TheWasian/Group5-ENGG3000/ESP-32 Code/Digram.png

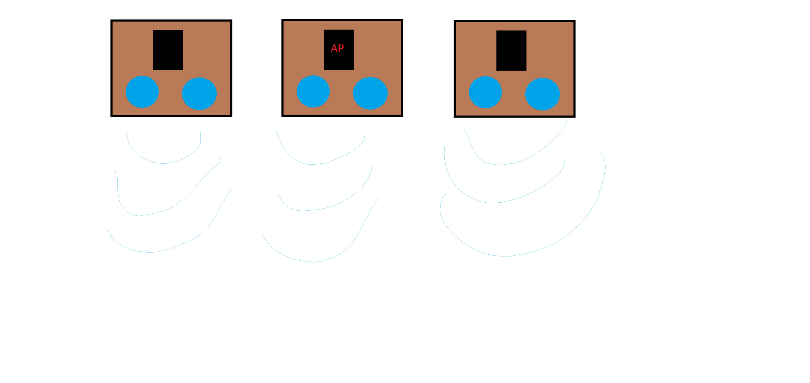
ESP-32 Code/Digram.png
