TheWasian/Group5-ENGG3000/WeeklyLogs/Images/Dash.png.png

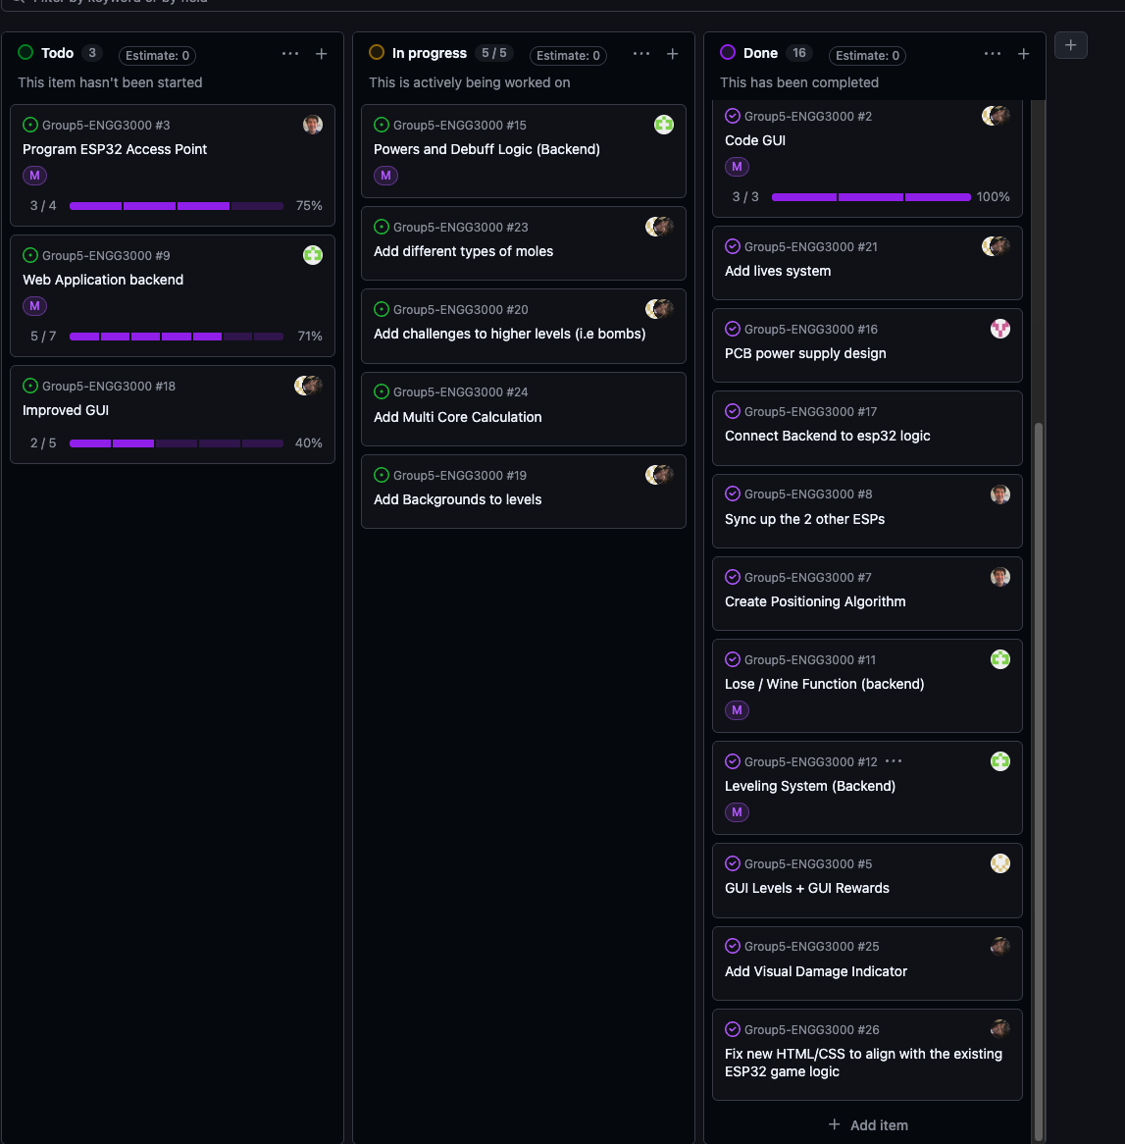
WeeklyLogs/Images/Dash.png.png
