TheWasian/Group5-ENGG3000/WeeklyLogs/Images/Dashboard 2.png

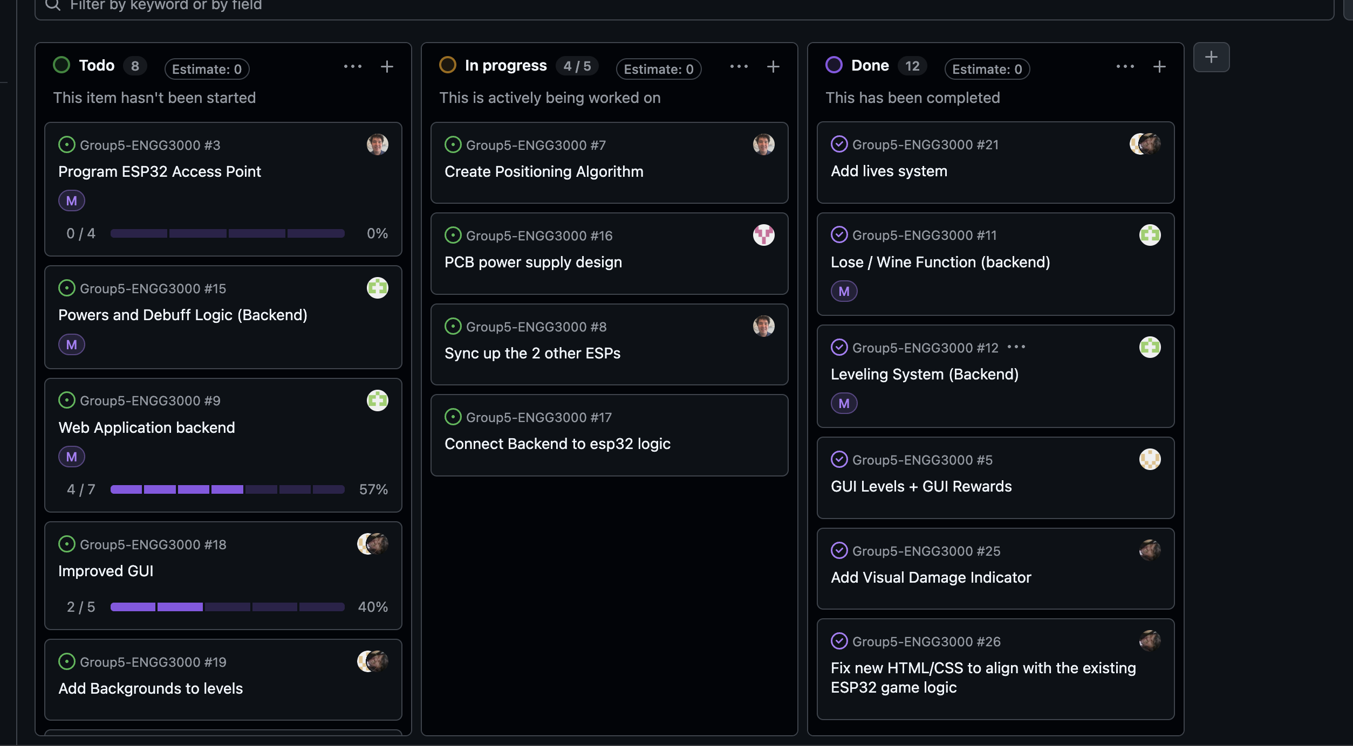
WeeklyLogs/Images/Dashboard 2.png
