TheWasian/Group5-ENGG3000/WeeklyLogs/Images/Dashboard.png

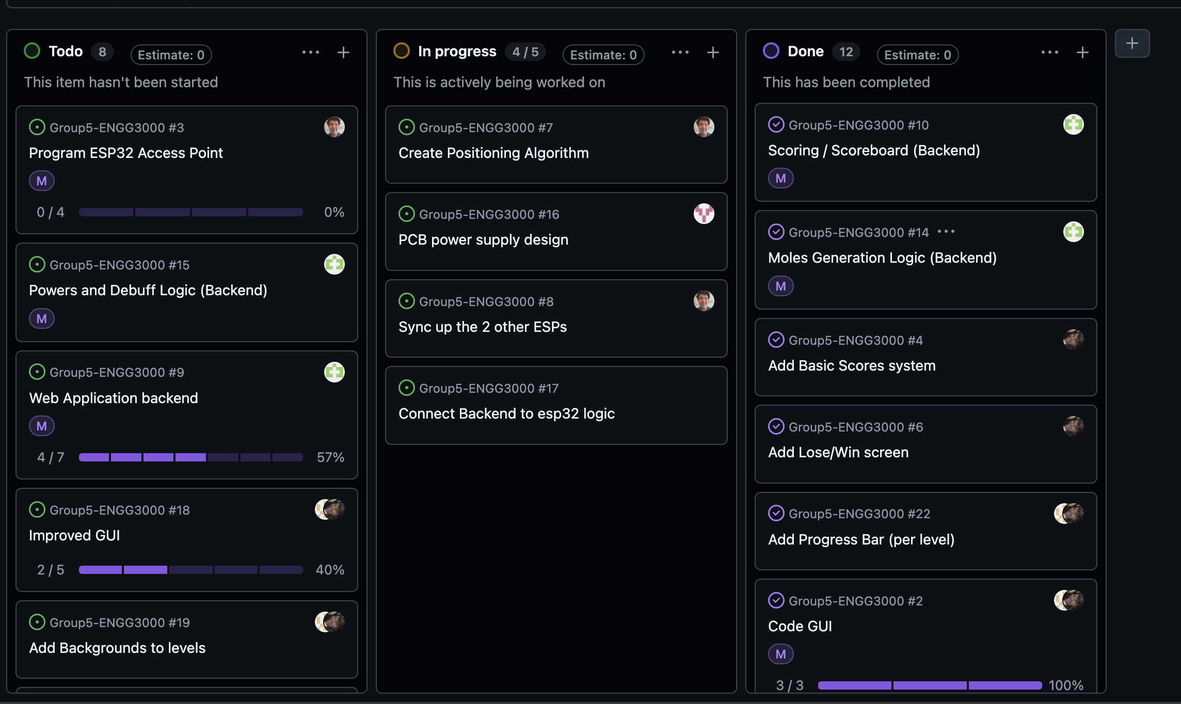
WeeklyLogs/Images/Dashboard.png
