TheWasian/Group5-ENGG3000/WeeklyLogs/Images/ImprovedUI.png.png

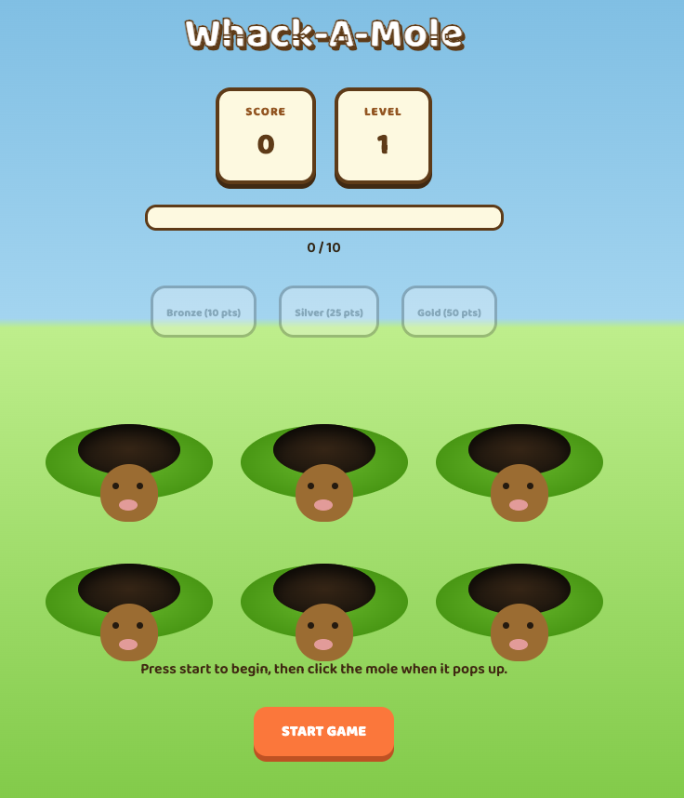
WeeklyLogs/Images/ImprovedUI.png.png
