TheWasian/Group5-ENGG3000/WeeklyLogs/Images/intersectionCalculation.png

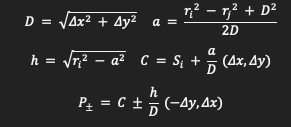
WeeklyLogs/Images/intersectionCalculation.png
