TheWasian/Group5-ENGG3000/WeeklyLogs/Images/loseCond.png.png

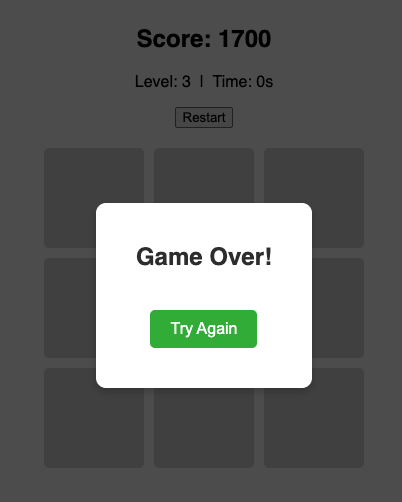
WeeklyLogs/Images/loseCond.png.png
