TheWasian/Group5-ENGG3000/WeeklyLogs/Images/PCBV1.png

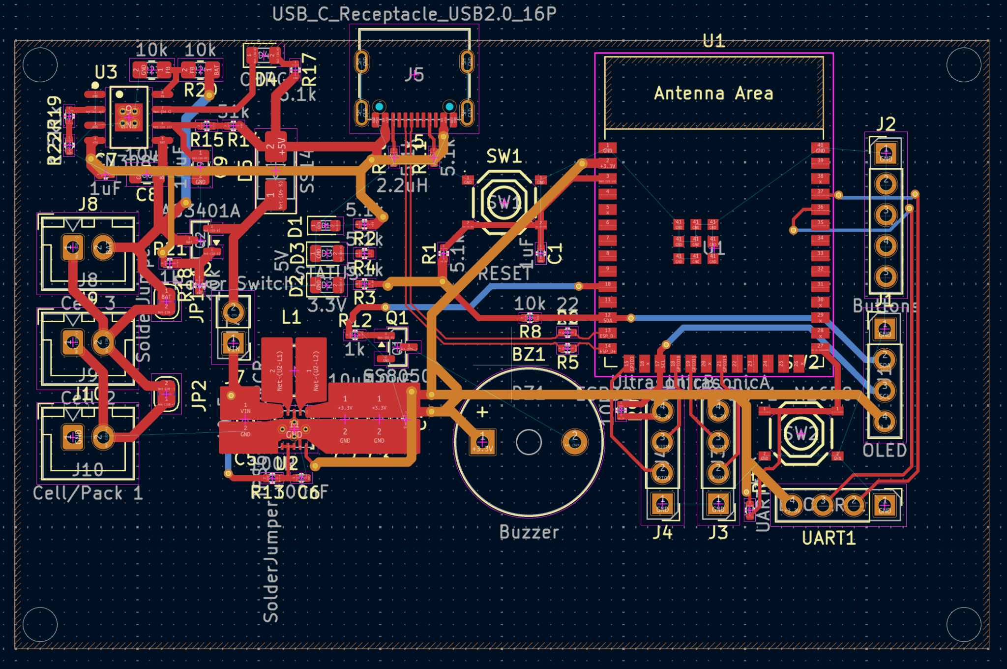
WeeklyLogs/Images/PCBV1.png
