TheWasian/Group5-ENGG3000/WeeklyLogs/Images/scrumweek1.png

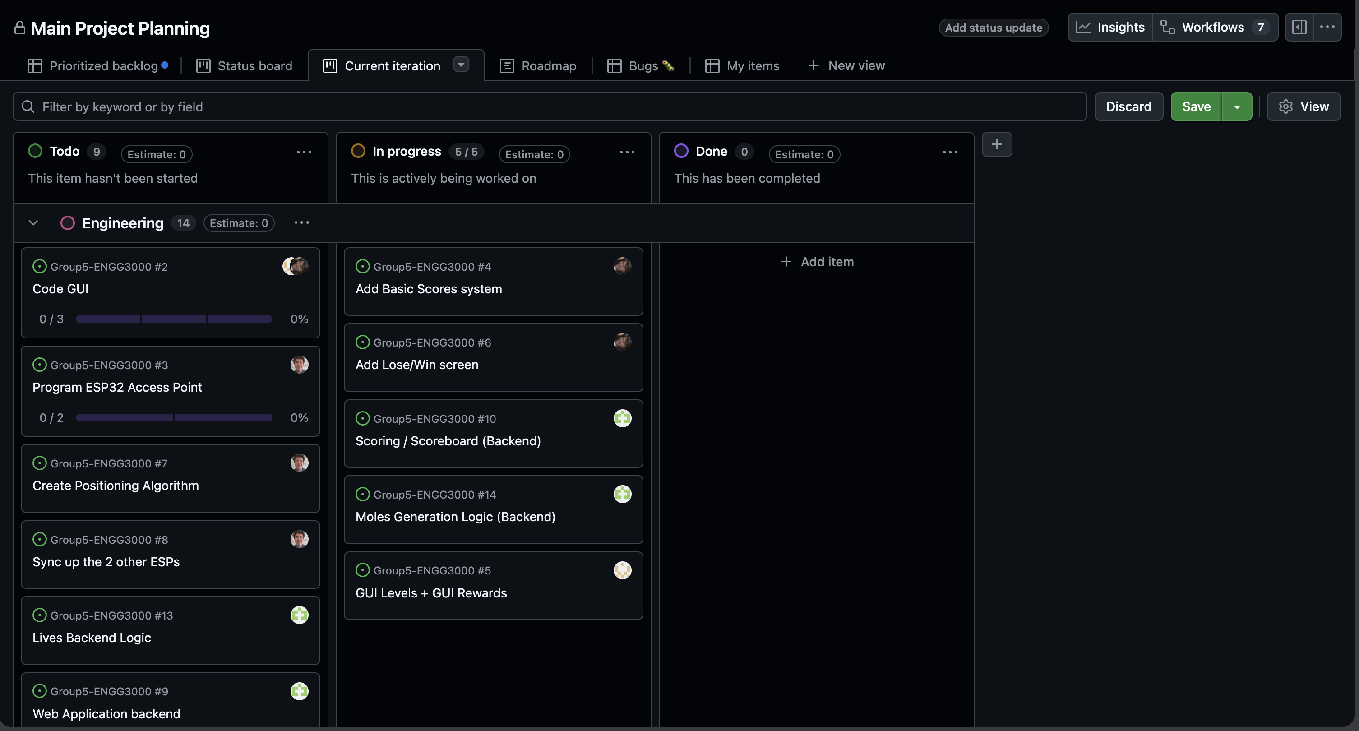
WeeklyLogs/Images/scrumweek1.png
