TheWasian/Group5-ENGG3000/WeeklyLogs/Images/skeletonUI2.png.png

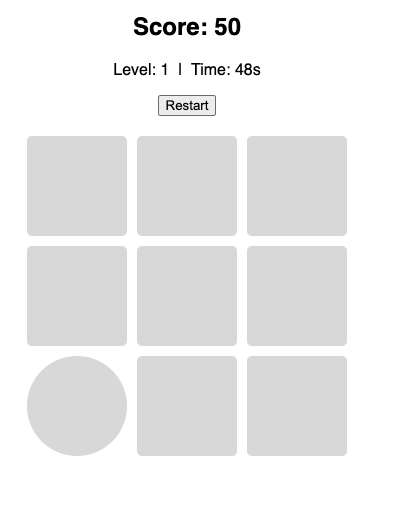
WeeklyLogs/Images/skeletonUI2.png.png
