TheWasian/Group5-ENGG3000/WeeklyLogs/Images/skeletonui.png.png

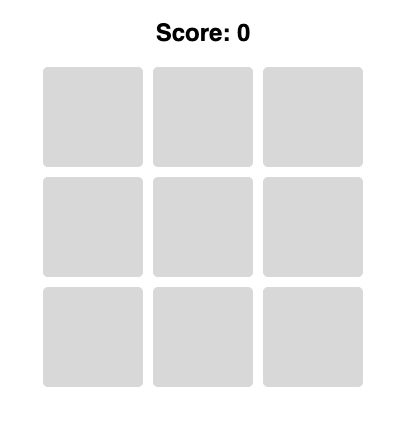
WeeklyLogs/Images/skeletonui.png.png
