TheWasian/Group5-ENGG3000/WeeklyLogs/Images/Week5board1.png

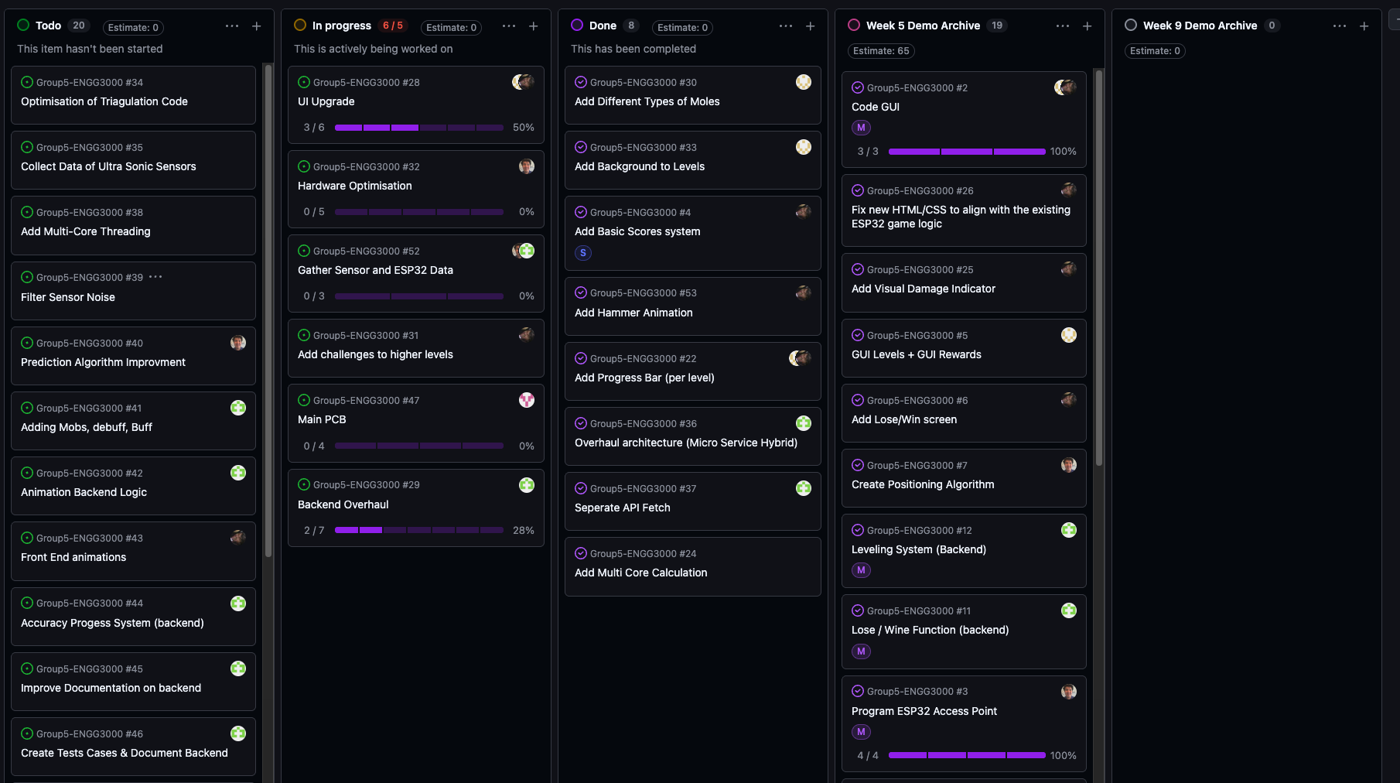
WeeklyLogs/Images/Week5board1.png
