TheWasian/Group5-ENGG3000/WeeklyLogs/Images/WeekDashboard.png

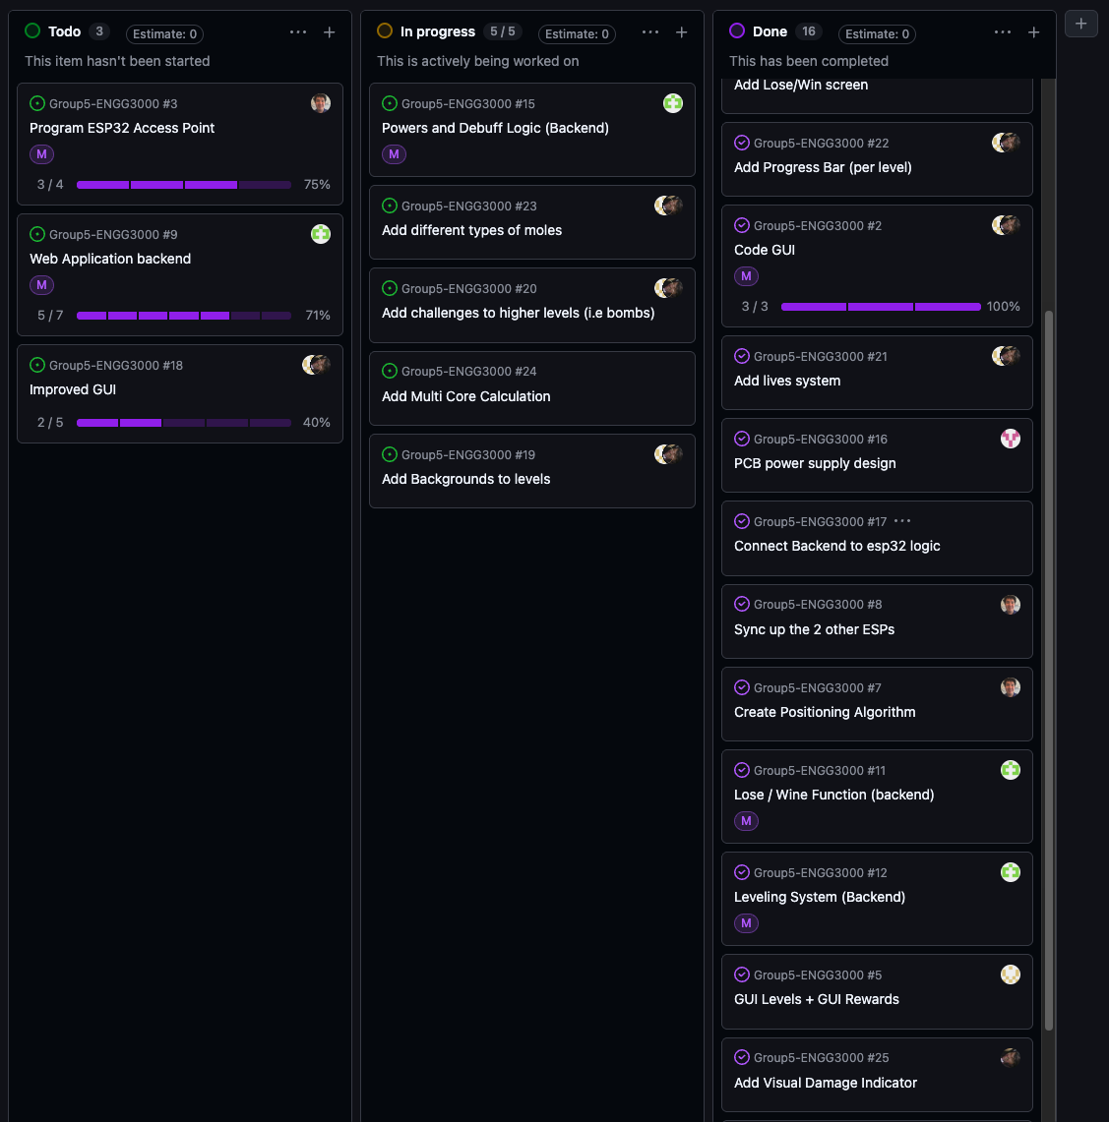
WeeklyLogs/Images/WeekDashboard.png
