TheWasian/Group5-ENGG3000/WeeklyLogs/Images/winCond.png.png

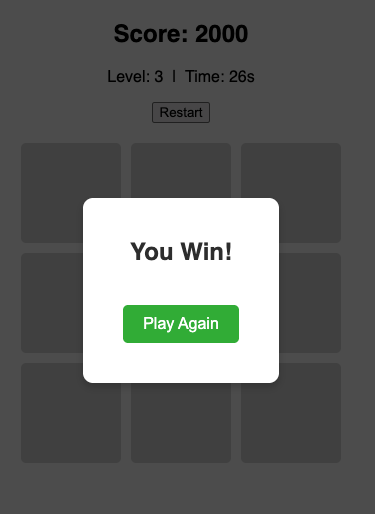
WeeklyLogs/Images/winCond.png.png
