TheWasian/Group5-ENGG3000/Bill_of_materials.md

*Bill of mateirals*

PCB: $25 (for 3). 
Sensors: $5 x 4 = 20.   
all the other kit (motor, usb c cord, wires, breadboard) = $14.   

total estimated cost = $54. 

Box been updated to 15x10x10cm (you can have it smaller but this is the max)
