TheWasian/Group5-ENGG3000/ESP-32 Code/calibration/output/room_echo_test_20261030_154447_214857.csv

host_utc | label | boot_id | frame_id | frame_start_ms | frame_end_ms | quiet_ms | frame_pause_ms | left_cm | master_cm | right_cm | left_status | master_status | right_status | left_received_ms | master_measured_ms | right_received_ms | master_echo_us | position_valid | x_m | y_m | rms_m | sensors_used | position_reason | actual_left_cm | actual_master_cm | actual_right_cm | phase | burst_number | repetition | pulse_number | pulses_per_sensor | repetitions_per_setting | burst_pause_ms | ap_observed_burst_gap_ms | left_echo_time_us | master_echo_time_us | right_echo_time_us | left_echo_source | master_echo_source | right_echo_source
2026-10-30T04:44:47.872+00:00 |  | 856965060 | 1 | 33819 | 34233 | 100 | 0 |  |  |  | no_ready | no_echo | no_ready |  | 33850 |  | 0 | False |  |  |  | 0 | disabled |  |  |  | conditioning | 0 | 0 | 1 | 10 | 3 |  |  |  |  |  | reconstructed_from_rounded_range | measured_pulse_width | reconstructed_from_rounded_range
2026-10-30T04:44:48.359+00:00 |  | 856965060 | 2 | 34334 | 34746 | 100 | 0 |  |  |  | no_ready | no_echo | no_ready |  | 34365 |  | 0 | False |  |  |  | 0 | disabled |  |  |  | conditioning | 0 | 0 | 2 | 10 | 3 |  |  |  |  |  | reconstructed_from_rounded_range | measured_pulse_width | reconstructed_from_rounded_range
2026-10-30T04:44:48.873+00:00 |  | 856965060 | 3 | 34847 | 35259 | 100 | 0 |  |  |  | no_ready | no_echo | no_ready |  | 34878 |  | 0 | False |  |  |  | 0 | disabled |  |  |  | conditioning | 0 | 0 | 3 | 10 | 3 |  |  |  |  |  | reconstructed_from_rounded_range | measured_pulse_width | reconstructed_from_rounded_range
2026-10-30T04:44:49.387+00:00 |  | 856965060 | 4 | 35360 | 35772 | 100 | 0 |  |  |  | no_ready | no_echo | no_ready |  | 35391 |  | 0 | False |  |  |  | 0 | disabled |  |  |  | conditioning | 0 | 0 | 4 | 10 | 3 |  |  |  |  |  | reconstructed_from_rounded_range | measured_pulse_width | reconstructed_from_rounded_range
2026-10-30T04:44:49.901+00:00 |  | 856965060 | 5 | 35873 | 36285 | 100 | 0 |  |  |  | no_ready | no_echo | no_ready |  | 35904 |  | 0 | False |  |  |  | 0 | disabled |  |  |  | conditioning | 0 | 0 | 5 | 10 | 3 |  |  |  |  |  | reconstructed_from_rounded_range | measured_pulse_width | reconstructed_from_rounded_range
2026-10-30T04:44:50.413+00:00 |  | 856965060 | 6 | 36386 | 36798 | 100 | 0 |  |  |  | no_ready | no_echo | no_ready |  | 36417 |  | 0 | False |  |  |  | 0 | disabled |  |  |  | conditioning | 0 | 0 | 6 | 10 | 3 |  |  |  |  |  | reconstructed_from_rounded_range | measured_pulse_width | reconstructed_from_rounded_range
2026-10-30T04:44:50.927+00:00 |  | 856965060 | 7 | 36899 | 37311 | 100 | 0 |  |  |  | no_ready | no_echo | no_ready |  | 36930 |  | 0 | False |  |  |  | 0 | disabled |  |  |  | conditioning | 0 | 0 | 7 | 10 | 3 |  |  |  |  |  | reconstructed_from_rounded_range | measured_pulse_width | reconstructed_from_rounded_range
2026-10-30T04:44:51.953+00:00 |  | 856965060 | 9 | 37925 | 38338 | 100 | 0 |  |  |  | no_ready | no_echo | no_ready |  | 37956 |  | 0 | False |  |  |  | 0 | disabled |  |  |  | conditioning | 0 | 0 | 8 | 10 | 3 |  |  |  |  |  | reconstructed_from_rounded_range | measured_pulse_width | reconstructed_from_rounded_range
2026-10-30T04:44:52.468+00:00 |  | 856965060 | 10 | 38439 | 38852 | 100 | 0 |  |  |  | no_ready | no_echo | no_ready |  | 38470 |  | 0 | False |  |  |  | 0 | disabled |  |  |  | conditioning | 0 | 0 | 9 | 10 | 3 |  |  |  |  |  | reconstructed_from_rounded_range | measured_pulse_width | reconstructed_from_rounded_range
