TheWasian/Group5-ENGG3000/CAD/box base 70mm horn.stl

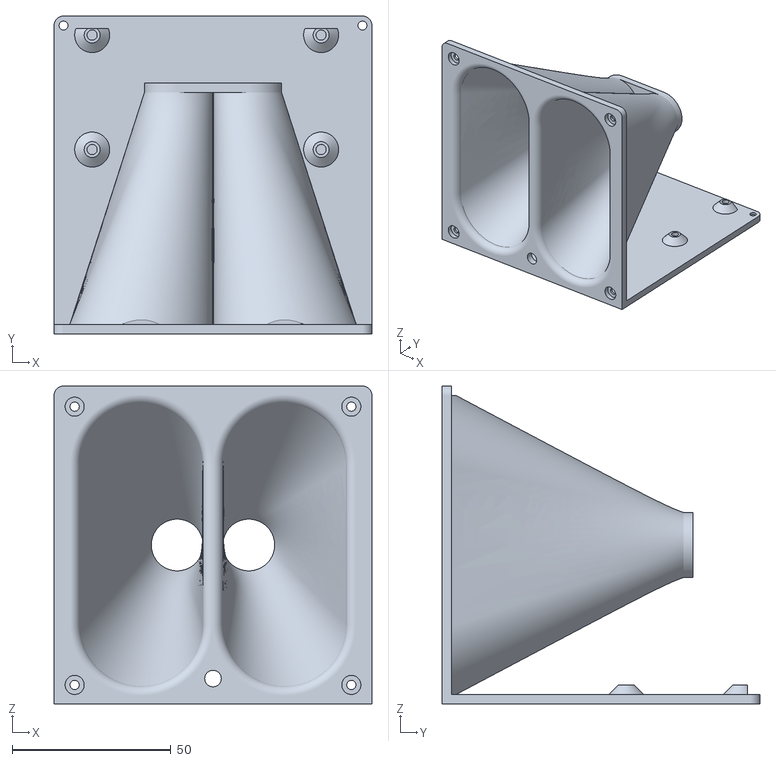
[picture p20: CAD file, 2026-10-20]
CAD/box base 70mm horn.stl
100.0 x 100.0 x 100.0
