TheWasian/Group5-ENGG3000/CAD/LCD lid .stl

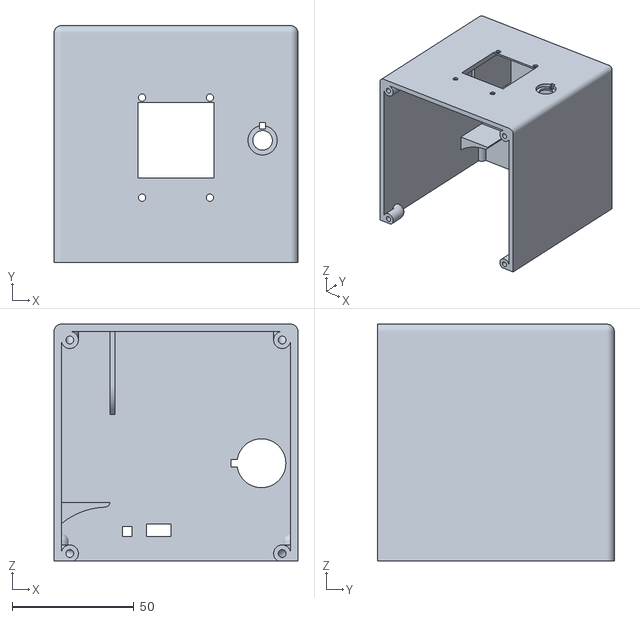
[picture p22: CAD file, 2026-10-20]
CAD/LCD lid .stl
100.0 x 97.0 x 97.0
