TheWasian/Group5-ENGG3000/ENGG3000-BaseStation/ManualTesting.ods

Actual (cm) | Entries
 | 1 | 2 | 3 | 4 | 5
0 | 798.3 | 798.29 | 798.42 | 798.24 | 798.37
10 | 9.45 | 10.13 | 9.1 | 9.77 | 9.79
20 | 19.99 | 19.36 | 19.36 | 19.99 | 19.04
30 | 29.12 | 29.1 | 29.09 | 29.12 | 29.19
50 | 48.99 | 48.59 | 48.59 | 48.6 | 48.19
60 | 55.91 | 55.9 | 56.32 | 55.9 | 56.34
70 | 61.51 | 65.55 | 61.57 | 59.69 | 65.98
