TheWasian/Group5-ENGG3000/ESP-32 Code/calibration/output/ESP32_Positioning_Maths_Explained.docx

# ESP32 positioning maths explained

Whack a Mole presentation notes

The system converts ultrasonic echo times into distances, estimates the player’s position, filters unreliable results and selects a mole hole. These notes explain the game calculations and the separate room echo test. Settings reflect the code checked on 3 November 2026.

# 1 Measure distance from echo time

- Each ultrasonic sensor sends a sound burst and measures the ECHO pulse duration representing the return travel time. The code assumes a sound speed of 343 metres per second.

d = c × t / 2

- d is distance in metres, c is sound speed in metres per second, and t is the round trip time in seconds. Divide by two because the sound travels to the target and back.

d in metres = t in microseconds × 0.000343 / 2

- Example: an echo duration of 6000 microseconds gives 6000 × 0.000343 / 2 = 1.029 metres.

# 2 Turn distances into possible positions

- Each sensor has a known position (xᵢ, yᵢ). A distance rᵢ places the target somewhere on a circle around that sensor.

(x − xᵢ)² + (y − yᵢ)² = rᵢ²

- One distance cannot uniquely locate the target. Two or three distances constrain where the circles can meet.
- The method is trilateration or multilateration because it uses distances. Triangulation uses measured angles; our mounting angles are configured directions, not angles measured by the sensors.

# 3 Find a position with two sensors

- For a simple coordinate system with sensors at (0, 0) and (b, 0), b is the gap between the sensor faces and r₁ and r₂ are their measured distances.

x = (r₁² − r₂² + b²) / (2b)

y = ±√(r₁² − x²)

- Two circles can produce two intersections. The code checks both against the tracking area and both sensor cones, and accepts only one remaining valid solution.
- No intersection means the ranges are inconsistent. Two plausible intersections mean the result is ambiguous. One sensor alone cannot produce a new position.

# 4 Fit a position with three sensors

- Real measurements contain noise, so three circles rarely meet at exactly one point. The solver searches for the position that best explains all three distances.

Predicted distance r̂ᵢ = √((x − xᵢ)² + (y − yᵢ)²)

Distance error eᵢ = r̂ᵢ − rᵢ

- Huber loss penalises small errors quadratically and large errors approximately linearly. This reduces the influence of outliers without automatically treating them as correct.
- An iterative Levenberg–Marquardt method adjusts x and y to reduce the combined loss. The code tries multiple starting positions to reduce dependence on its first guess.
- A consistent three-sensor solution is preferred. If it fails, the code tests two-sensor pairs and uses geometry, agreement and recent tracking information to reject ambiguous alternatives.
- Presentation wording: We find the position that best explains the measured distances while reducing the influence of unusually large errors.

# 5 Check whether the position is believable

RMS distance error = √((e₁² + e₂² + e₃²) / 3)

- The current three-sensor acceptance limits are 10 cm RMS distance error and 18 cm maximum individual distance error.
- The code also rejects weak geometry: when the sensor directions provide nearly the same information, small range errors can cause large position errors.
- The estimated position uncertainty limit is 20 cm. This is a geometry and noise model, not proof of 20 cm real-world accuracy.
- A two-circle solution has zero fitting error by construction. That does not make it perfectly accurate; the original measurements can still be wrong.
- Candidate positions must lie within the configured tracking area and the cones of the sensors used. Measurements must also be sufficiently close in time.

# 6 Account for the sensor housing

- Distance geometry should use the metal sensor faces, rather than the horn openings. The configured setback moves each sensor’s reference position backwards along its mounting direction.

x_sensor = x_opening − s × sin(θ)

y_sensor = y_opening − s × cos(θ)

- s is the axial setback and θ is the bearing measured from the forward direction, positive towards the right. The current configured setback is 55 mm for all three sensors.
- The setback shifts the coordinates; it is not also subtracted from the echo distance. The fitted setback still needs to match the physical hardware.

# 7 Filter jumps and choose the mole hole

- The position mode filter groups recent solved coordinates into 5 cm cells and chooses the most frequently occupied cell. The current window contains up to three valid positions, with history expiring after 500 ms.
- The output is an actual measured position from the winning cell, not an average or an invented cell centre. If no cell repeats, the latest measurement is used.
- A movement greater than the current 14 cm jump threshold requires another nearby reading to confirm it. This helps distinguish real movement from an isolated spike.
- The configured game area is divided into two columns and three rows. The player’s accepted x and y coordinates determine the corresponding hole.
- A 5 cm boundary margin, called hysteresis, reduces switching near a boundary. A hole change requires two stable frames. Held positions are for display and cannot score new hits.

# 8 Relate pulse timing to update rate

- In the game firmware, the sensors fire sequentially. Each sensor receives a slot of S milliseconds, so a complete cycle contains three slots.

Cycle time ≈ 3S milliseconds

Position update rate ≈ 1000 / (3S) updates per second

- With the current SLOT_MS of 50, a full cycle takes approximately 150 ms, giving about 6.7 updates per second before extra scheduling delays.
- A 100 ms slot gives approximately 300 ms per cycle, or 3.3 updates per second. Longer intervals allow more time between emissions but also more player movement between measurements.
- Webpage polling only changes how often the browser fetches results. It does not change the ultrasonic firing schedule. The 10 microsecond trigger width is also separate from the delay between readings.

# 9 Understand the room echo test graph

- The calibration test keeps the quiet delay within a burst fixed and sweeps the additional pause between bursts. It repeats bursts at each pause setting and saves every reading.
- Each plotted point uses all valid pulses across those repeats. The point is their mean echo time; the error bar is sample standard deviation, showing how spread out the readings are.

Mean = sum of valid echo times / number of valid readings

- The centre reports measured ECHO width. The existing nodes report rounded distances, so their echo times are reconstructed using time in microseconds = 2 × distance in cm / 0.0343. They are labelled separately.

# What to say in a presentation

“Each sensor converts echo travel time into distance. We combine at least two distances with known sensor positions to estimate the player’s location. With three sensors, we find a robust best fit. We reject inconsistent results, filter isolated jumps and map the accepted position to a mole hole.”

- Main limitation: the 2D model assumes a common reflecting target point. Different body surfaces, height differences and background reflections can violate that assumption, so filtering cannot guarantee an accurate position.
