TheWasian/Group5-ENGG3000/ESP-32 Code/calibration/output/ultrasonic_calibration.csv

real_distance_cm | sample_number | measured_distance_cm
10.0 | 1 | 16.996
10.0 | 2 | 57.847
10.0 | 3 | 56.458
10.0 | 4 | 56.441
10.0 | 5 | -1.0
10.0 | 6 | 58.704
10.0 | 7 | -1.0
10.0 | 8 | 58.293
10.0 | 9 | 56.458
10.0 | 10 | 46.751
