TheWasian/Group5-ENGG3000/ESP-32 Code/calibration/output/room_echo_test.csv

delay_ms | sample_number | echo_time_us | timed_out
0 | 1 | 0 | True
0 | 2 | 0 | True
0 | 3 | 0 | True
0 | 4 | 0 | True
0 | 5 | 0 | True
0 | 6 | 0 | True
0 | 7 | 0 | True
0 | 8 | 0 | True
0 | 9 | 0 | True
0 | 10 | 0 | True
0 | 11 | 0 | True
0 | 12 | 0 | True
0 | 13 | 0 | True
0 | 14 | 0 | True
0 | 15 | 0 | True
0 | 16 | 0 | True
0 | 17 | 0 | True
0 | 18 | 0 | True
0 | 19 | 0 | True
0 | 20 | 0 | True
0 | 21 | 0 | True
0 | 22 | 0 | True
0 | 23 | 0 | True
0 | 24 | 0 | True
0 | 25 | 0 | True
0 | 26 | 0 | True
0 | 27 | 0 | True
0 | 28 | 0 | True
0 | 29 | 0 | True
0 | 30 | 0 | True
0 | 31 | 0 | True
0 | 32 | 0 | True
0 | 33 | 0 | True
0 | 34 | 0 | True
0 | 35 | 0 | True
0 | 36 | 0 | True
0 | 37 | 0 | True
0 | 38 | 0 | True
0 | 39 | 0 | True
0 | 40 | 0 | True
0 | 41 | 0 | True
0 | 42 | 0 | True
0 | 43 | 0 | True
0 | 44 | 0 | True
0 | 45 | 0 | True
0 | 46 | 0 | True
0 | 47 | 0 | True
0 | 48 | 0 | True
0 | 49 | 0 | True
0 | 50 | 0 | True
1 | 1 | 0 | True
1 | 2 | 0 | True
1 | 3 | 0 | True
1 | 4 | 0 | True
1 | 5 | 0 | True
1 | 6 | 0 | True
1 | 7 | 0 | True
1 | 8 | 0 | True
1 | 9 | 0 | True
1 | 10 | 0 | True
1 | 11 | 0 | True
1 | 12 | 0 | True
1 | 13 | 0 | True
1 | 14 | 0 | True
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
