TheWasian/Group5-ENGG3000/ESP-32 Code/calibration/output/room_echo_test_standard_deviation.png

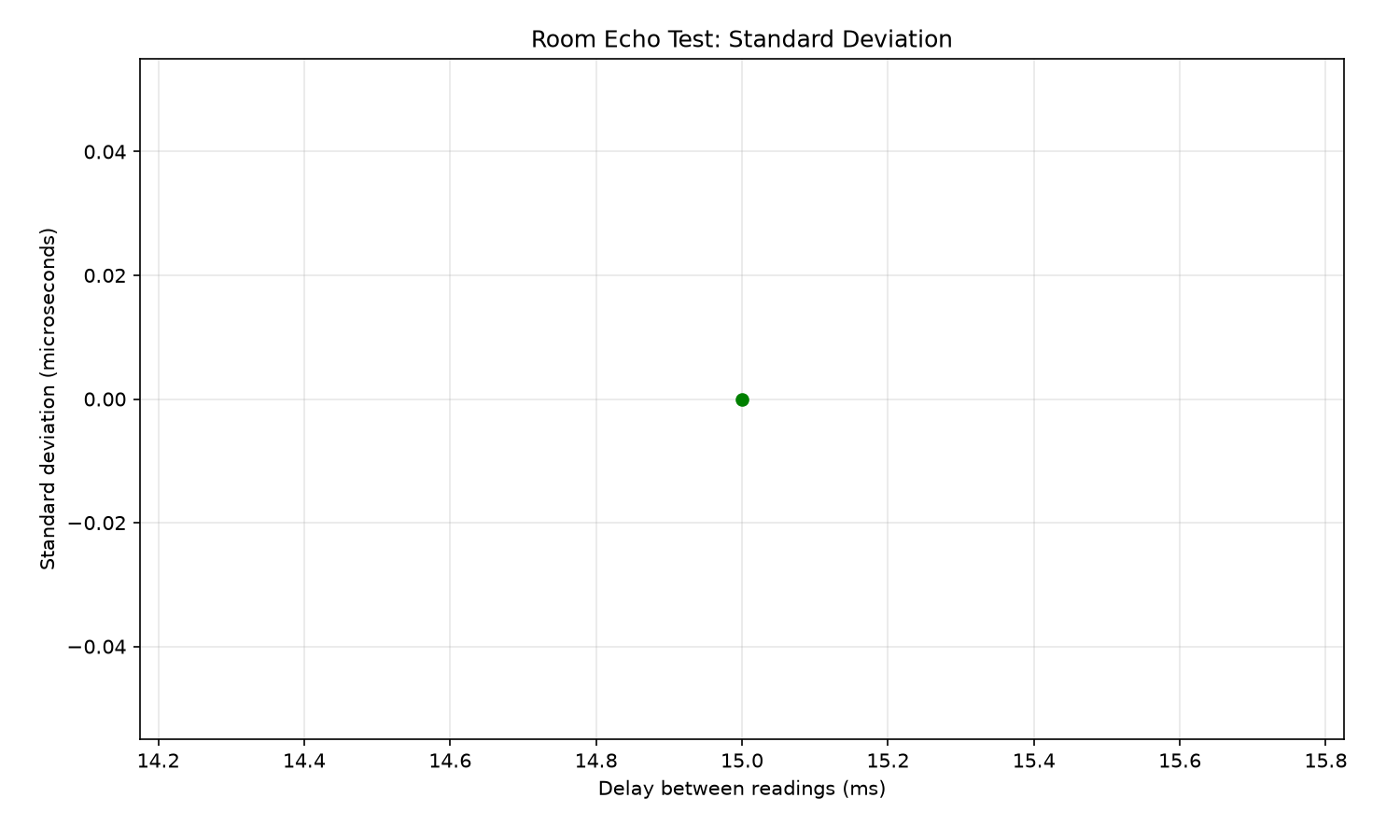
ESP-32 Code/calibration/output/room_echo_test_standard_deviation.png
