TheWasian/Group5-ENGG3000/ESP-32 Code/calibration/output/ultrasonic_calibration.png

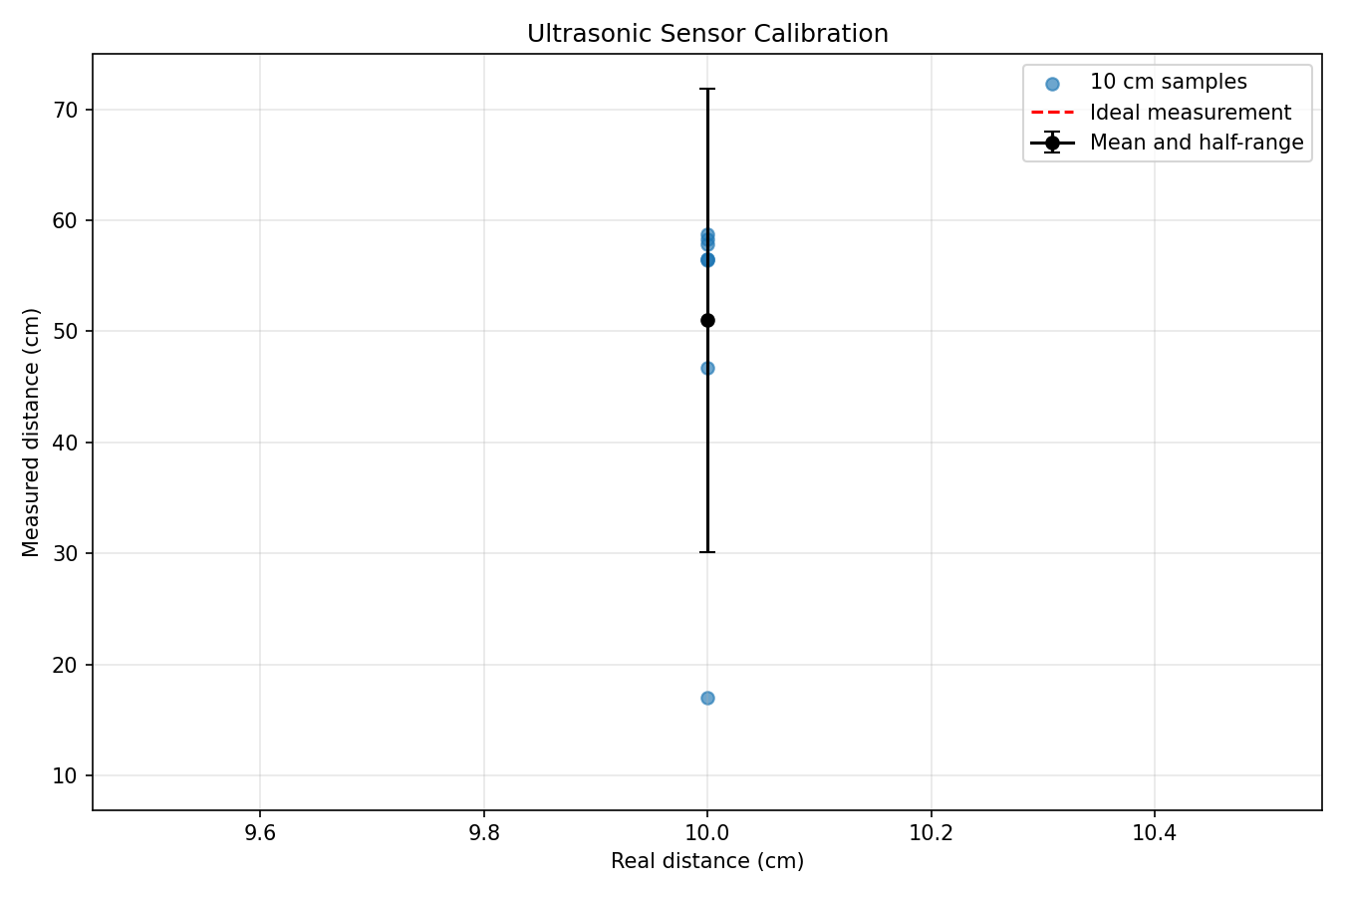
ESP-32 Code/calibration/output/ultrasonic_calibration.png
