TheWasian/Group5-ENGG3000/WeeklyLogs/Images/FrontendTest.png

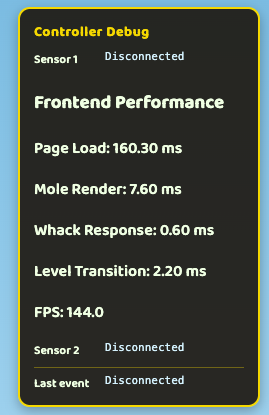
WeeklyLogs/Images/FrontendTest.png
