TheWasian/Group5-ENGG3000/ENGG3000-BaseStation/Print Schematic.pdf

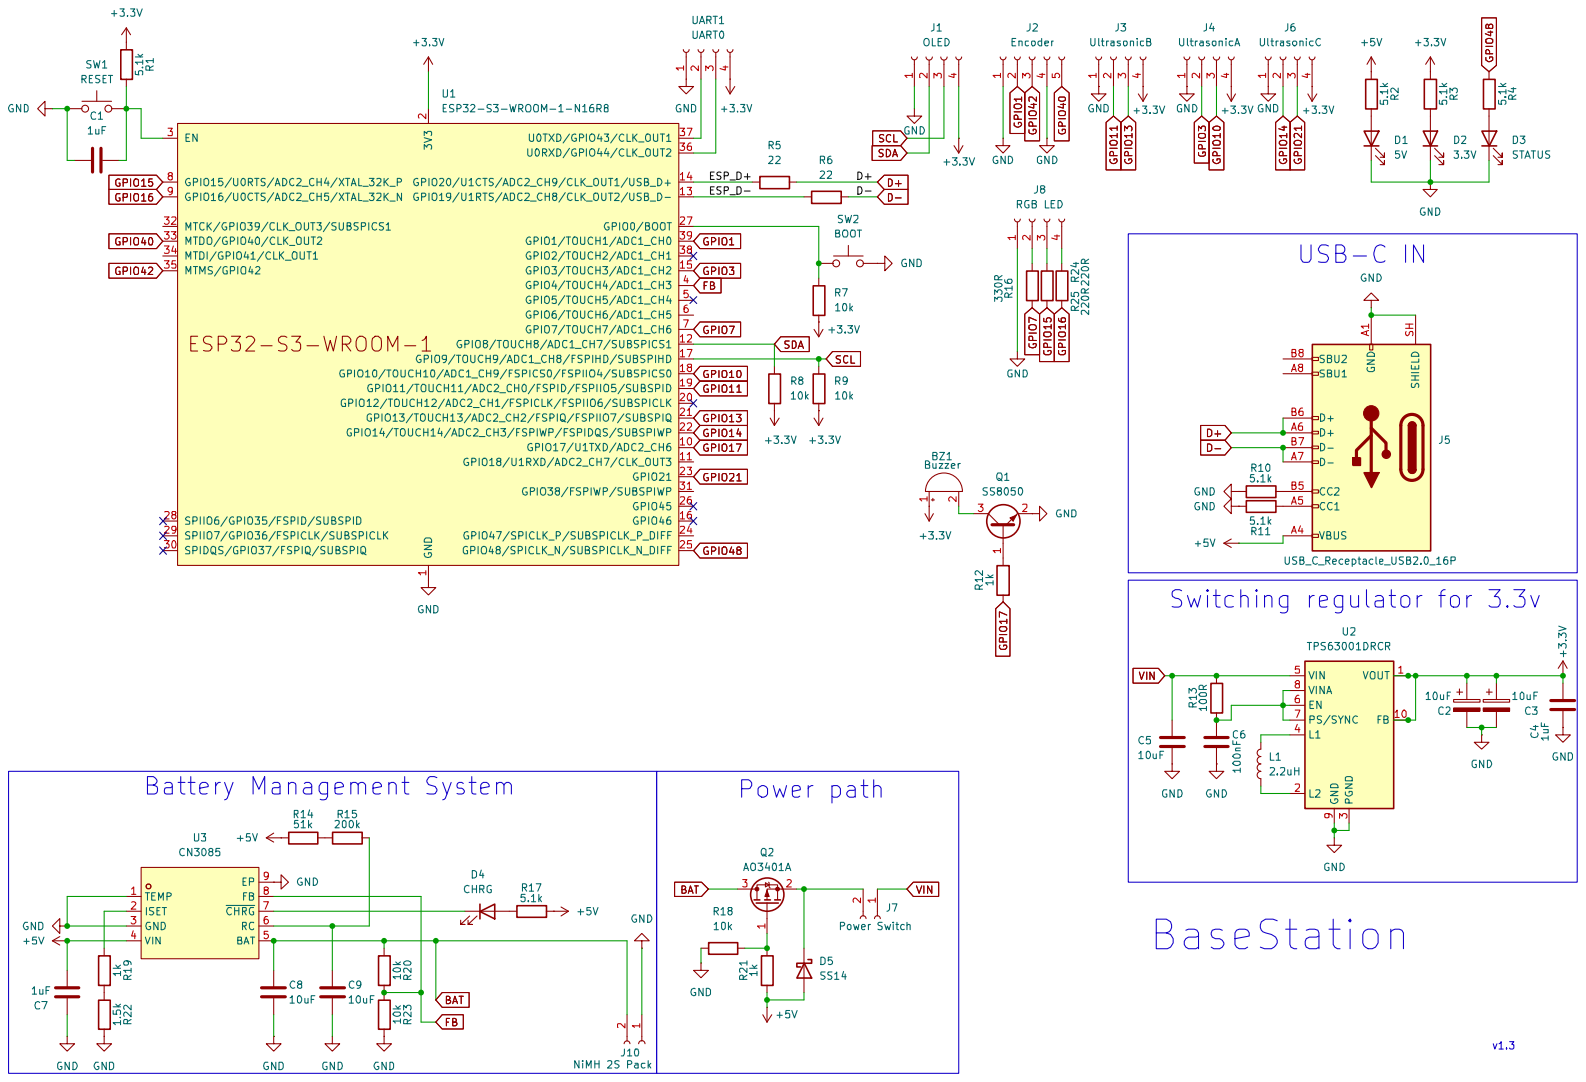
[picture p28: page 1]
