TheWasian/Group5-ENGG3000/ENGG3000-BaseStation/ENGG3000-BaseStation.kicad_pcb

## KiCad design ENGG3000-BaseStation/ENGG3000-BaseStation.kicad_pcb (2026-10-04)

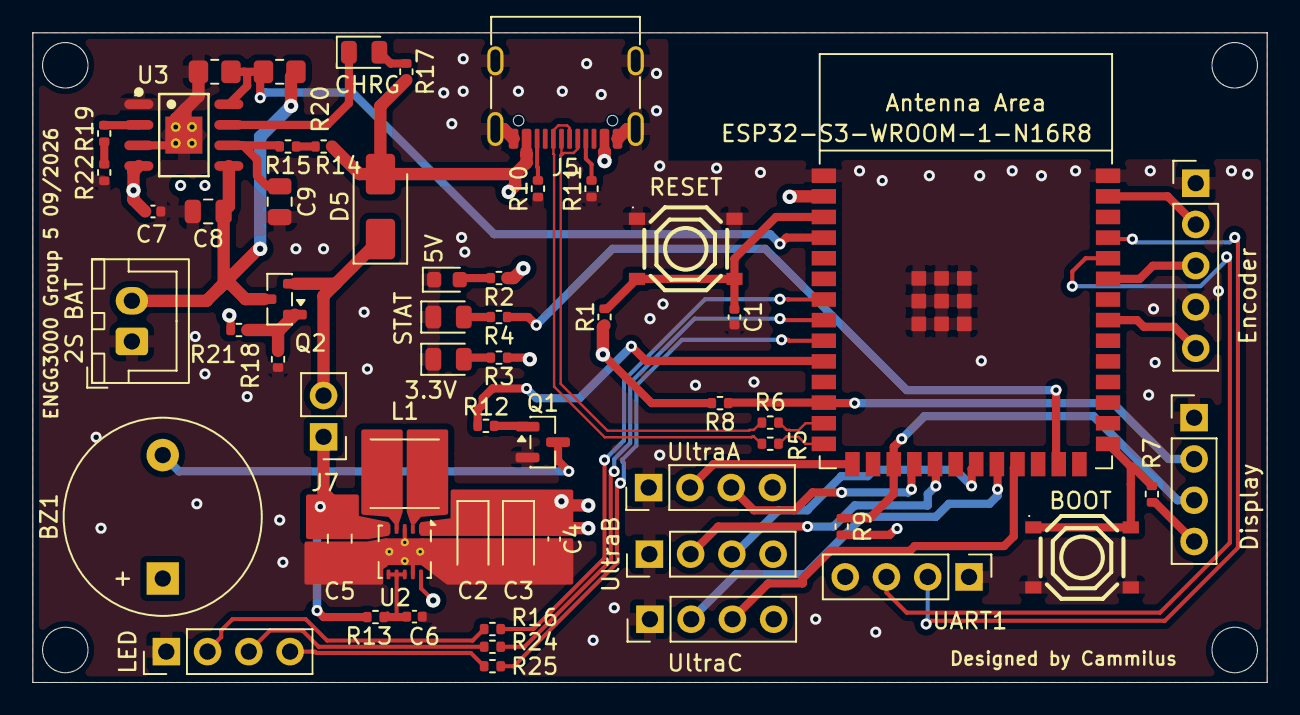
[picture p29: board ENGG3000-BaseStation.kicad_pcb from above]

Board: 4 copper layers, 76.0 x 40.0 mm, 58 parts (0 on the bottom side), 51 nets.

Parts:
2S BAT: NiMH 2S Pack; JST_XH_B2B-XH-A_1x02_P2.50mm_Vertical
3.3V: 3.3V; LED_0805_2012Metric
5V: 5V; LED_0603_1608Metric
BOOT: BOOT; SW-SMD_4P-L5.1-W5.1-P3.70-LS6.5-TL_H1.5
BZ1: Buzzer; Buzzer_12x9.5RM7.6
C1, C4, C7: 1uF; C_0402_1005Metric
C2, C3: 10uF; CP_EIA-3216-18_Kemet-A
C5, C8, C9: 10uF; C_0805_2012Metric
C6: 100nF; C_0402_1005Metric
CHRG: CHRG; LED_0805_2012Metric
D5: SS14; D_SMA
Display: OLED; PinHeader_1x04_P2.54mm_Vertical
ESP32-S3-WROOM-1-N16R8: ESP32-S3-WROOM-1-N16R8; ESP32-S3-WROOM-1
Encoder: Encoder; PinHeader_1x05_P2.54mm_Vertical
J5: USB_C_Receptacle_USB2.0_16P; USB_C_Receptacle_G-Switch_GT-USB-7010ASV
J7: Power Switch; PinHeader_1x02_P2.54mm_Vertical
L1: 2.2uH; L_APV_ANR4020
LED: RGB LED; PinHeader_1x04_P2.54mm_Vertical
Q1: SS8050; SOT-23
Q2: AO3401A; SOT-23
R1, R2, R3, R4, R10, R11, R17: 5.1k; R_0402_1005Metric
R5, R6: 22; R_0402_1005Metric
R7, R8, R9, R18: 10k; R_0402_1005Metric
R12, R19, R21: 1k; R_0402_1005Metric
R13: 100R; R_0402_1005Metric
R14: 51k; R_0402_1005Metric
R15: 200k; R_0402_1005Metric
R16: 330R; R_0402_1005Metric
R20, R23: 10k; R_0805_2012Metric_Pad1.20x1.40mm_HandSolder
R22: 1.5k; R_0402_1005Metric
R24, R25: 220R; R_0402_1005Metric
RESET: RESET; SW-SMD_4P-L5.1-W5.1-P3.70-LS6.5-TL_H1.5
STAT: STATUS; LED_0805_2012Metric
U2: TPS63001DRCR; Texas_DRC0010J_ThermalVias
U3: CN3085; SOP-8_L4.9-W3.9-P1.27-LS6.0-BL-EP
UART1: UART0; PinHeader_1x04_P2.54mm_Vertical
UltraA: UltrasonicB; PinHeader_1x04_P2.54mm_Vertical
UltraB: UltrasonicA; PinHeader_1x04_P2.54mm_Vertical
UltraC: UltrasonicC; PinHeader_1x04_P2.54mm_Vertical

Connections:
+3.3V: BZ1.1 (+), C2.1, C3.1, C4.1, Display.4 (3.3V), ESP32-S3-WROOM-1-N16R8.2 (3V3), R1.1, R3.1, R7.2, R8.2, R9.2, U2.1 (VOUT), U2.10 (FB), UART1.4 (3.3V), UltraA.4 (3.3V), UltraB.4 (3.3V), UltraC.4 (3.3V)
+5V: C7.1, D5.2 (A), J5.A4 (VBUS), J5.A9 (VBUS), J5.B4 (VBUS), J5.B9 (VBUS), R2.1, R14.1, R17.2, R21.1, U3.4 (VIN)
/ESP_D+: ESP32-S3-WROOM-1-N16R8.14 (GPIO20/U1CTS/ADC2_CH9/CLK_OUT1/USB_D+), R5.1
/ESP_D-: ESP32-S3-WROOM-1-N16R8.13 (GPIO19/U1RTS/ADC2_CH8/CLK_OUT2/USB_D-), R6.1
BAT: 2S BAT.2 (+), C8.1, Q2.3 (D), R20.1, U3.5 (BAT)
D+: J5.A6 (D+), J5.B6 (D+), R5.2
D-: J5.A7 (D-), J5.B7 (D-), R6.2
FB: ESP32-S3-WROOM-1-N16R8.4 (GPIO4/TOUCH4/ADC1_CH3), R20.2, R23.1, U3.8 (FB)
GND: 2S BAT.1 (-), 3.3V.1 (K), 5V.1 (K), BOOT.2, C1.2, C2.2, C3.2, C4.2, C5.2, C6.2, C7.2, C8.2, C9.2, Display.1 (GND), ESP32-S3-WROOM-1-N16R8.1 (GND), ESP32-S3-WROOM-1-N16R8.40 (GND), ESP32-S3-WROOM-1-N16R8.41 (GND), Encoder.1 (GND), Encoder.4 (Button_C), J5.A1 (GND), J5.A12 (GND), J5.B1 (GND), J5.B12 (GND), J5.SH (SHIELD), LED.1 (GND), Q1.2 (E), R10.1, R11.1, R18.1, R22.2, R23.2, RESET.1, STAT.1 (K), U2.3 (PGND), U2.9 (GND), U2.11 (PGND), U3.1 (TEMP), U3.3 (GND), U3.9 (EP), UART1.1 (GND), UltraA.1 (GND), UltraB.1 (GND), UltraC.1 (GND)
GPIO1: ESP32-S3-WROOM-1-N16R8.39 (GPIO1/TOUCH1/ADC1_CH0), Encoder.2 (Button_A)
GPIO3: ESP32-S3-WROOM-1-N16R8.15 (GPIO3/TOUCH3/ADC1_CH2), UltraA.2 (TRIG)
GPIO7: ESP32-S3-WROOM-1-N16R8.7 (GPIO7/TOUCH7/ADC1_CH6), R16.2
GPIO10: ESP32-S3-WROOM-1-N16R8.18 (GPIO10/TOUCH10/ADC1_CH9/FSPICS0/FSPIIO4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), UltraA.3 (ECHO)
GPIO11: ESP32-S3-WROOM-1-N16R8.19 (GPIO11/TOUCH11/ADC2_CH0/FSPID/FSPIIO5/S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), UltraB.2 (TRIG)
GPIO13: ESP32-S3-WROOM-1-N16R8.21 (GPIO13/TOUCH13/ADC2_CH2/FSPIQ/FSPIIO7/S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), UltraB.3 (ECHO)
GPIO14: ESP32-S3-WROOM-1-N16R8.22 (GPIO14/TOUCH14/ADC2_CH3/FSPIWP/FSPIDQS/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), UltraC.2 (TRIG)
GPIO15: ESP32-S3-WROOM-1-N16R8.8 (GPIO15/U0RTS/ADC2_CH4/XTAL_32K_P), R24.1
GPIO16: ESP32-S3-WROOM-1-N16R8.9 (GPIO16/U0CTS/ADC2_CH5/XTAL_32K_N), R25.1
GPIO17: ESP32-S3-WROOM-1-N16R8.10 (GPIO17/U1TXD/ADC2_CH6), R12.1
GPIO21: ESP32-S3-WROOM-1-N16R8.23 (GPIO21), UltraC.3 (ECHO)
GPIO40: ESP32-S3-WROOM-1-N16R8.33 (MTDO/GPIO40/CLK_OUT2), Encoder.5 (Button_D)
GPIO43: ESP32-S3-WROOM-1-N16R8.35 (MTMS/GPIO42), Encoder.3 (Button_B)
GPIO48: ESP32-S3-WROOM-1-N16R8.25 (GPIO48/SPICLK_N/SUBSPICLK_N_DIFF), R4.1
unnamed: BZ1.2 (-), Q1.3 (C)
unnamed: 5V.2 (A), R2.2
unnamed: 3.3V.2 (A), R3.2
unnamed: R4.2, STAT.2 (A)
unnamed: CHRG.2 (A), R17.1
unnamed: CHRG.1 (K), U3.7 (~CHRG)
unnamed: D5.1 (K), J7.2 (+), Q2.2 (S)
unnamed: J5.A5 (CC1), R11.2
unnamed: J5.B5 (CC2), R10.2
unnamed: LED.4 (B), R25.2
unnamed: LED.3 (G), R24.2
unnamed: LED.2 (R), R16.1
unnamed: Q1.1 (B), R12.2
unnamed: Q2.1 (G), R18.2, R21.2
unnamed: R14.2, R15.1
unnamed: R19.2, R22.1
unnamed: C1.1, ESP32-S3-WROOM-1-N16R8.3 (EN), R1.2, RESET.2
unnamed: BOOT.1, ESP32-S3-WROOM-1-N16R8.27 (GPIO0/BOOT), R7.1
unnamed: ESP32-S3-WROOM-1-N16R8.36 (U0RXD/GPIO44/CLK_OUT2), UART1.3 (RXD)
unnamed: ESP32-S3-WROOM-1-N16R8.37 (U0TXD/GPIO43/CLK_OUT1), UART1.2 (TXD)
unnamed: C6.1, R13.1, U2.6 (EN), U2.7 (PS/SYNC), U2.8 (VINA)
unnamed: L1.2, U2.4 (L1)
unnamed: L1.1, U2.2 (L2)
unnamed: R19.1, U3.2 (ISET)
unnamed: C9.1, R15.2, U3.6 (RC)
SCL: Display.3 (RXD), ESP32-S3-WROOM-1-N16R8.17 (GPIO9/TOUCH9/ADC1_CH8/FSPIHD/SUBSPIHD), R9.1
SDA: Display.2 (TXD), ESP32-S3-WROOM-1-N16R8.12 (GPIO8/TOUCH8/ADC1_CH7/SUBSPICS1), R8.1
VIN: C5.1, J7.1 (-), R13.2, U2.5 (VIN)
