TheWasian/Group5-ENGG3000/ESP-32 Code/Access_Point/image.h

// 'Screenshot 2026-11-03 at 11', 128x160px
const uint16_t epd_bitmap_Screenshot_2026_11_03_at_11 [] PROGMEM = {
	0xdefb, 0xe6fb, 0xe6fb, 0xdefb, 0xe6fb, 0xe6fb, 0xe6fb, 0xe6fb, 0xe71b, 0xe71b, 0xe71b, 0xe71b, 0xe71b, 0xe71b, 0xe71b, 0xe71b, 
	0xe71b, 0xe71b, 0xe71b, 0xe71b, 0xe71b, 0xe71b, 0xe71b, 0xe71b, 0xe71b, 0xe73c, 0xe73b, 0xe71b, 0xe73b, 0xe73b, 0xe71b, 0xe73b, 
	0xe73b, 0xe73b, 0xe73b, 0xe73b, 0xe73c, 0xe73b, 0xe73b, 0xe73c, 0xe73b, 0xe73b, 0xe73b, 0xef3c, 0xef3c, 0xe73c, 0xe73c, 0xe73c, 
	0xef3c, 0xef5c, 0xef5c, 0xef5c, 0xef5c, 0xef5c, 0xef3c, 0xef5c, 0xef5c, 0xef5c, 0xef5c, 0xef3c, 0xef3c, 0xef5c, 0xef5c, 0xef5c, 
	0xef5c, 0xef5c, 0xef5c, 0xef5c, 0xef5c, 0xef5c, 0xef5c, 0xef5c, 0xef5c, 0xef5c, 0xef5c, 0xef5c, 0xef5c, 0xef5c, 0xef5c, 0xef5c, 
	0xef5c, 0xef5c, 0xef5c, 0xef5c, 0xef5c, 0xef5c, 0xef5c, 0xef5c, 0xef3c, 0xef5c, 0xef5c, 0xef5c, 0xef5c, 0xef5c, 0xef5c, 0xef5c, 
	0xef5c, 0xef5c, 0xef5c, 0xef5c, 0xef5c, 0xef5c, 0xef5c, 0xef5c, 0xef5c, 0xef3c, 0xef5c, 0xef3c, 0xef5c, 0xef5c, 0xef3c, 0xef3c, 
	0xef3c, 0xef5c, 0xef3c, 0xef3c, 0xef3c, 0xef3b, 0xef3c, 0xef3c, 0xef3c, 0xef3c, 0xef3c, 0xe73b, 0xe73b, 0xe73b, 0xe73b, 0xe73b, 
	0xdefb, 0xe6fb, 0xe6fb, 0xdefb, 0xe6fb, 0xe6fb, 0xe71b, 0xdefb, 0xe71b, 0xe71b, 0xe71b, 0xe71b, 0xe71b, 0xe71b, 0xe71b, 0xe71c, 
	0xe71b, 0xe71b, 0xe71b, 0xe71b, 0xe71b, 0xe71b, 0xe71b, 0xe71b, 0xe71b, 0xe73b, 0xe73b, 0xe71b, 0xe73b, 0xe71b, 0xe73b, 0xe73b, 
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
};

// Array of all bitmaps for convenience. (Total bytes used to store images in PROGMEM = 20496)
const int epd_bitmap_allArray_LEN = 1;
const uint16_t* epd_bitmap_allArray[1] = {
	epd_bitmap_Screenshot_2026_11_03_at_11
};
