TheWasian/Group5-ENGG3000/ESP-32 Code/calibration/scripts/calibrate_ultrasonic.py

"""Collect ultrasonic calibration data from an ESP32 and plot the results."""

from __future__ import annotations

import argparse
import configparser
import csv
import math
import statistics
from pathlib import Path
from time import sleep
from typing import Union

try:
    from .calibration_mode import (
        SensorMode,
        parse_multi_sensor_distances,
        serial_command,
        select_sensor_mode,
    )
except ImportError:
    from calibration_mode import (
        SensorMode,
        parse_multi_sensor_distances,
        serial_command,
        select_sensor_mode,
    )


PROJECT_ROOT = Path(__file__).resolve().parent.parent
PLATFORMIO_CONFIG = PROJECT_ROOT / "platformio.ini"
OUTPUT_DIR = PROJECT_ROOT / "output"
SENSOR_NAMES = ("left", "master", "right")
CalibrationMeasurements = Union[list[float], dict[str, list[float]]]


def read_platformio_value(option: str, config_path: Path = PLATFORMIO_CONFIG) -> str:
    """Read an option from the first PlatformIO environment."""
    config = configparser.ConfigParser()
    config.read(config_path)

    for section in config.sections():
        if section.startswith("env:") and config.has_option(section, option):
            return config.get(section, option).strip()

    raise ValueError(f"No {option} found in {config_path}")


def parse_measurements(line: str) -> list[float]:
    """Parse one ESP32 response line into distance measurements in centimetres."""
    values = [value.strip() for value in line.strip().split(",") if value.strip()]
    if not values:
        raise ValueError("The response did not contain any measurements")
    return [float(value) for value in values]


def request_measurements(
    connection: object, sample_count: int, sensor_mode: SensorMode
) -> CalibrationMeasurements:
    """Request and read one burst of measurements from the ESP32."""
    connection.reset_input_buffer()
    if sensor_mode == "single":
        connection.write(serial_command(sensor_mode, "CALIBRATE", ""))
        connection.write(f"{sample_count}\n".encode("ascii"))
    else:
        connection.write(serial_command(sensor_mode, "", f"MULTI_CALIBRATE {sample_count} 1000"))

    if sensor_mode == "multi":
        measurements_by_sensor = {name: [] for name in SENSOR_NAMES}
    else:
        measurements: list[float] = []

    while (
        len(measurements) < sample_count
        if sensor_mode == "single"
        else len(measurements_by_sensor["master"]) < sample_count
    ):
        raw_line = connection.readline()
        if not raw_line:
            raise TimeoutError("Timed out waiting for the ESP32 response")

        line = raw_line.decode("utf-8", errors="replace").strip()
        if line.startswith("MODE:") or line.startswith("E ("):
            continue
        if sensor_mode == "multi":
            sensor_distances = parse_multi_sensor_distances(line)
            if sensor_distances is not None:
                for sensor_name in SENSOR_NAMES:
                    measurements_by_sensor[sensor_name].append(
                        sensor_distances[sensor_name]
                    )
            continue
        try:
            single_measurements = parse_measurements(line)
        except ValueError:
            continue

        if len(single_measurements) != sample_count:
            print(
                f"Ignoring response with {len(single_measurements)} samples; "
                f"expected {sample_count}."
            )
            continue
        return single_measurements
    return measurements if sensor_mode == "single" else measurements_by_sensor


def prompt_positive_float(prompt: str) -> float:
    """Prompt until the user enters a positive floating-point value."""
    while True:
        try:
            value = float(input(prompt))
        except ValueError:
            print("Enter a number greater than zero.")
            continue
        if value > 0:
            return value
        print("Enter a number greater than zero.")


def prompt_positive_int(prompt: str) -> int:
    """Prompt until the user enters a positive integer."""
    while True:
        try:
            value = int(input(prompt))
        except ValueError:
            print("Enter a whole number greater than zero.")
            continue
        if value > 0:
            return value
        print("Enter a whole number greater than zero.")


def collect_distances(
    connection: object, sample_count: int, sensor_mode: SensorMode
) -> dict[float, CalibrationMeasurements]:
    """Collect bursts until the user submits an empty distance prompt."""
    results: dict[float, list[float]] = {}
    print("Enter each measured real distance in centimetres. Press Enter when finished.")

    while True:
        distance_text = input("Real distance (cm): ").strip()
        if not distance_text:
            if results:
                return results
            print("Enter at least one distance before finishing.")
            continue

        try:
            real_distance = float(distance_text)
        except ValueError:
            print("Enter a number greater than zero.")
            continue
        if real_distance <= 0:
            print("Enter a number greater than zero.")
            continue

        print(f"Requesting {sample_count} samples at {real_distance:g} cm...")
        measurements = request_measurements(connection, sample_count, sensor_mode)
        results[real_distance] = measurements
        values = measurements["master"] if isinstance(measurements, dict) else measurements
        valid_count = sum(math.isfinite(measurement) and measurement > 0 for measurement in values)
        print(f"Received {valid_count}/{sample_count} valid measurements.")


def save_csv(
    results: dict[float, CalibrationMeasurements], output_path: Path
) -> None:
    """Save the raw calibration readings for later analysis."""
    with output_path.open("w", newline="", encoding="utf-8") as output_file:
        writer = csv.writer(output_file)
        is_multi_sensor = any(isinstance(item, dict) for item in results.values())
        if is_multi_sensor:
            writer.writerow(
                [
                    "real_distance_cm",
                    "sample_number",
                    "left_measured_distance_cm",
                    "master_measured_distance_cm",
                    "right_measured_distance_cm",
                ]
            )
        else:
            writer.writerow(["real_distance_cm", "sample_number", "measured_distance_cm"])
        for real_distance, measurements in results.items():
            if isinstance(measurements, list):
                for sample_number, measurement in enumerate(measurements, start=1):
                    if is_multi_sensor:
                        writer.writerow([real_distance, sample_number, "", measurement, ""])
                    else:
                        writer.writerow([real_distance, sample_number, measurement])
                continue
            for sample_number in range(len(measurements["master"])):
                writer.writerow(
                    [
                        real_distance,
                        sample_number + 1,
                        measurements["left"][sample_number],
                        measurements["master"][sample_number],
                        measurements["right"][sample_number],
                    ]
                )


def fit_exponential_calibration(
    results: dict[float, list[float]],
) -> tuple[float, float, float]:
    """Fit real distance = coefficient * exp(exponent * measured distance)."""
    points = [
        (measurement, real_distance)
        for real_distance, measurements in results.items()
        for measurement in measurements
        if measurement > 0 and real_distance > 0
    ]
    if len(points) < 2:
        raise ValueError("At least two positive calibration samples are required")

    measured_distances = [point[0] for point in points]
    log_real_distances = [math.log(point[1]) for point in points]
    measured_mean = statistics.mean(measured_distances)
    log_real_mean = statistics.mean(log_real_distances)
    denominator = sum(
        (measured - measured_mean) ** 2 for measured in measured_distances
    )
    if denominator == 0:
        raise ValueError("Calibration samples must contain different measured distances")

    exponent = sum(
        (measured - measured_mean) * (log_real - log_real_mean)
        for measured, log_real in zip(measured_distances, log_real_distances)
    ) / denominator
    coefficient = math.exp(log_real_mean - exponent * measured_mean)

    real_mean = statistics.mean(point[1] for point in points)
    total_sum_squares = sum((real - real_mean) ** 2 for _, real in points)
    residual_sum_squares = sum(
        (real - coefficient * math.exp(exponent * measured)) ** 2
        for measured, real in points
    )
    r_squared = (
        1 - residual_sum_squares / total_sum_squares
        if total_sum_squares
        else 1.0
    )
    return coefficient, exponent, r_squared


def save_calibration_equation(
    coefficient: float, exponent: float, r_squared: float, output_path: Path
) -> None:
    """Save the fitted correction equation for use in production code."""
    with output_path.open("w", encoding="utf-8") as output_file:
        output_file.write("Ultrasonic distance correction\n")
        output_file.write(
            "real_distance_cm = coefficient * exp(exponent * measured_distance_cm)\n"
        )
        output_file.write(f"coefficient = {coefficient:.12g}\n")
        output_file.write(f"exponent = {exponent:.12g}\n")
        output_file.write(f"r_squared = {r_squared:.6f}\n")


def plot_results(
    results: dict[float, CalibrationMeasurements],
    output_path: Path | None = None,
    calibration_output_path: Path | None = None,
) -> None:
    """Plot every received sample and the mean measured distance per real distance."""
    try:
        import matplotlib.pyplot as plt
    except ImportError as error:
        raise SystemExit(
            "matplotlib is required; install it with: python3 -m pip install matplotlib"
        ) from error

    coefficient, exponent, r_squared = fit_exponential_calibration(
        {
            real_distance: measurements["master"]
            for real_distance, measurements in results.items()
            if isinstance(measurements, dict)
        }
        if all(isinstance(measurements, dict) for measurements in results.values())
        else results
    )

    figure, axes = plt.subplots(figsize=(9, 6))
    for sensor_name in (
        SENSOR_NAMES if isinstance(next(iter(results.values())), dict) else ("single",)
    ):
        real_distances: list[float] = []
        means: list[float] = []
        for real_distance, result in sorted(results.items()):
            sensor_measurements = (
                result if isinstance(result, list) else result[sensor_name]
            )
            valid_measurements = [
                measurement for measurement in sensor_measurements if measurement >= 0
            ]
            if not valid_measurements:
                continue
            axes.scatter(
                [real_distance] * len(valid_measurements),
                valid_measurements,
                alpha=0.35,
                label=f"{sensor_name} samples",
            )
            real_distances.append(real_distance)
            means.append(statistics.mean(valid_measurements))
        if means:
            axes.plot(real_distances, means, "o-", label=f"{sensor_name} mean")

    axes.plot(real_distances, real_distances, "r--", label="Ideal measurement")
    axes.set_title("Ultrasonic Sensor Calibration")
    axes.set_xlabel("Real distance (cm)")
    axes.set_ylabel("Measured distance (cm)")
    axes.grid(True, alpha=0.3)
    axes.legend()
    figure.tight_layout()

    if output_path is not None:
        figure.savefig(output_path, dpi=150)
        print(f"Saved graph to {output_path}")
    print(
        "Correction equation: "
        f"real_distance_cm = {coefficient:.12g} * "
        f"exp({exponent:.12g} * measured_distance_cm)"
    )
    if calibration_output_path is not None:
        save_calibration_equation(coefficient, exponent, r_squared, calibration_output_path)
        print(f"Saved correction equation to {calibration_output_path}")
    plt.show()


def plot_standard_deviation(
    results: dict[float, CalibrationMeasurements], output_path: Path | None = None
) -> None:
    """Plot the average absolute measurement deviation at each real distance."""
    try:
        import matplotlib.pyplot as plt
    except ImportError as error:
        raise SystemExit(
            "matplotlib is required; install it with: python3 -m pip install matplotlib"
        ) from error

    figure, axes = plt.subplots(figsize=(9, 6))
    for sensor_name in (
        SENSOR_NAMES if isinstance(next(iter(results.values())), dict) else ("single",)
    ):
        real_distances: list[float] = []
        average_deviations: list[float] = []
        for real_distance, result in sorted(results.items()):
            measurements = result if isinstance(result, list) else result[sensor_name]
            valid_measurements = [measurement for measurement in measurements if measurement >= 0]
            if not valid_measurements:
                continue
            real_distances.append(real_distance)
            average_deviations.append(
                statistics.mean(abs(measurement - real_distance) for measurement in valid_measurements)
            )
        axes.plot(real_distances, average_deviations, "o-", label=sensor_name)
    axes.set_title("Ultrasonic Sensor Average Measurement Deviation")
    axes.set_xlabel("Real distance (cm)")
    axes.set_ylabel("Average absolute deviation (cm)")
    axes.grid(True, alpha=0.3)
    axes.legend()
    figure.tight_layout()

    if output_path is not None:
        figure.savefig(output_path, dpi=150)
        print(f"Saved standard deviation graph to {output_path}")
    plt.show()


def main() -> None:
    parser = argparse.ArgumentParser(description=__doc__)
    parser.add_argument("port", nargs="?", help="Override the serial port from platformio.ini")
    parser.add_argument("--baud", type=int, help="Override the baud rate from platformio.ini")
    parser.add_argument(
        "--output",
        type=Path,
        default=OUTPUT_DIR / "ultrasonic_calibration.png",
        help="Path for the generated graph (default: output/ultrasonic_calibration.png)",
    )
    parser.add_argument(
        "--csv",
        type=Path,
        default=OUTPUT_DIR / "ultrasonic_calibration.csv",
        help="Path for the raw readings CSV (default: output/ultrasonic_calibration.csv)",
    )
    parser.add_argument(
        "--standard-deviation-output",
        type=Path,
        default=OUTPUT_DIR / "ultrasonic_standard_deviation.png",
        help=(
            "Path for the standard deviation graph "
            "(default: output/ultrasonic_standard_deviation.png)"
        ),
    )
    parser.add_argument(
        "--calibration-output",
        type=Path,
        default=OUTPUT_DIR / "ultrasonic_calibration_equation.txt",
        help=(
            "Path for the production correction equation "
            "(default: output/ultrasonic_calibration_equation.txt)"
        ),
    )
    args = parser.parse_args()

    try:
        port = args.port or read_platformio_value("port")
        baud_rate = args.baud or int(read_platformio_value("monitor_speed"))
    except ValueError as error:
        raise SystemExit(error) from error

    sample_count = prompt_positive_int("Samples per distance: ")
    sensor_mode = select_sensor_mode()
    if sensor_mode == "multi":
        from multi_capture import interactive
        interactive(port, baud_rate, "calibrate", sample_count)
        return

    try:
        import serial
    except ImportError as error:
        raise SystemExit("pyserial is required; install it with: python3 -m pip install pyserial") from error

    try:
        with serial.Serial(port, baud_rate, timeout=3) as connection:
            print(f"Connected to {port} at {baud_rate} baud.")
            # Opening the port resets the ESP32; wait for its startup delay before sending commands.
            sleep(6)
            connection.reset_input_buffer()
            results = collect_distances(connection, sample_count, sensor_mode)
    except serial.SerialException as error:
        raise SystemExit(f"Could not open or read serial port {port!r}: {error}") from error
    except (KeyboardInterrupt, EOFError):
        print("\nCalibration cancelled.")
        return
    except TimeoutError as error:
        raise SystemExit(error) from error

    args.csv.parent.mkdir(parents=True, exist_ok=True)
    args.output.parent.mkdir(parents=True, exist_ok=True)
    args.standard_deviation_output.parent.mkdir(parents=True, exist_ok=True)
    args.calibration_output.parent.mkdir(parents=True, exist_ok=True)
    save_csv(results, args.csv)
    print(f"Saved raw readings to {args.csv}")
    plot_results(results, args.output, args.calibration_output)
    plot_standard_deviation(results, args.standard_deviation_output)


if __name__ == "__main__":
    main()
