TheWasian/Group5-ENGG3000/(commit log)

2026-08-03 initial design
    [DM-OLED096-636.step, ENGG3000-BaseStation.csv, ENGG3000-BaseStation.kicad_pcb, ENGG3000-BaseStation.kicad_sch, bom.csv, designators.csv, positions.csv]
2026-08-04 Fixed git ignore for kicad
2026-08-04 Deleting old folders
    [DM-OLED096-636.step, ENGG3000-BaseStation.kicad_sch]
2026-08-04 Simple bill of material, will need to be improved in later periods
2026-08-04 Added Sensor Code for Each ESP32
2026-08-10 Added the game logic: 1. Simple leveling system that increase up to level 3 (500, 1000, 2000) 2. Added a mole and made a simple randomisation script to spawn within the 3x3 pannels 3. Added a simple 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
    git push
2026-08-14 Component updates
    [ENGG3000-BaseStation.kicad_sch]
2026-08-19 added averaging calculations for ultrasonic sensor data
2026-08-19 Added a Game Launcher
    Added a .ps1 file that:
    First sees if it is a saved network
    If it is then connect to the network
    If not then Create a temporary Windows Wi-Fi profile containing Wacker5 and its password.
    request connection to Wacker5
    Wait until http://192.168.4.1 responds.
    Delete the temporary profile file.
    Then added a gamelauncher.bat file that runs the powershell commands
2026-08-24 added life loss indicator, logic preventing consecutive mole spawns in same hole, and restart button to end game screen
2026-08-24 Updated power path
    [ENGG3000-BaseStation.kicad_sch]
2026-08-29 Update to schematic
    [ENGG3000-BaseStation.kicad_sch]
2026-09-01 connect whack-a-mole UI to ESP32 access point positioning API
2026-09-01 Schematic update
    [ENGG3000-BaseStation.kicad_pcb]
2026-09-06 Sensor Calibration
    [ENGG3000-BaseStation.kicad_sch]
2026-09-08 updated to work with 3 sensors
2026-09-10 Calibration stuff
2026-09-15 Kicad footprint update
    [ENGG3000-BaseStation.kicad_pcb, ENGG3000-BaseStation.kicad_sch]
2026-09-15 PCB footprint addition and Calibration graphs added
    [ENGG3000-BaseStation.kicad_pcb, ENGG3000-BaseStation.kicad_sch, ultrasonic_calibration.csv]
2026-09-15 PCB footprint edits
    [ENGG3000-BaseStation.kicad_pcb, room_echo_test.csv, ultrasonic_calibration.csv]
2026-09-15 Production ready PCB
    [ENGG3000-BaseStation.kicad_pcb, ENGG3000-BaseStation.kicad_sch]
2026-09-22 All the things i added:
    Services (Splitting all the logic into multiple services)
    Environment Service
    Leveling Service
    Game conditions service
    Mole service
    Streaks Service
    High Score
    Sensore Service
    Reduced multiple poll’s into siguler polls aimed at reducing latency
    Added warning system
    Reorganised the backend debug box originally a bit harder to find now it is easier and within just one service
    Checking the status and inputting debugging consol logs especially for offline or faulty functions
    Main Service
    Handles the bare minimum like buttons, esp32 connection and mouse/start functions
    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
2026-10-04 PCB footprint update
    [ENGG3000-BaseStation.kicad_pcb, bom.csv, designators.csv, pcb.step, positions.csv]
2026-10-05 forgot to remove force active hole
2026-10-06 NEW CODE
    [Week_5_to_9_SYNTHETIC_demo_data.xlsx]
2026-10-13 Calibration config
2026-10-13 Multi sensor support for calibration
2026-10-20 CAD
    stl and glb files
2026-10-21 fixes to UI, Mole design, hole, and first background improvements
2026-10-21 Focused on adding
    1. constent polling, note i will need to test it on the pcb unless you can matthew
    2. Made the hammer just swing once even when the user isn't moving
    3.Relocated the html location so it is drawn a bit later
    That's kinda of it please tell me if their is an error
2026-10-27 Schematic pdf
2026-10-30 updated calibration
2026-11-02 Pin mode
2026-11-03 mole timer hopefully
2026-11-03 Fix false dead-zone alarms and enable the buzzer at 60 cm
    - Re-enable the proximity buzzer/LED output and set the dead zone to 60 cm
    as required by the brief.
    - Raw (unfiltered) dead-zone evidence must now repeat on 2 consecutive
    frames before sounding the alarm, so a single stray echo can no longer
    beep or block hits. The filtered position still warns immediately.
    - Pin the hole grid's far edge at 1.90 m so the taped hole positions
    don't move with the larger dead zone.
2026-11-04 Update README screenshot and hardware setup documentation
    - Replace the early interface image with the current 3D game screenshot.
    - Document 30 cm sensor spacing and 15.9° inward aiming angles.
    - Align housing setback and target positions with the firmware.
    - Explain the cone dashboard’s visualisation and calibration features.
    - Clarify that browser calibration does not change game hit zones.
