TheWasian/Group5-ENGG3000/(notices)

Notices in the files:
README.md:
License: MIT
